1m4n00b6292/ME4169-Microprocessor-Final-term-Project/Department of Electrical Engineering/Docs/Reverse Protection.jpg

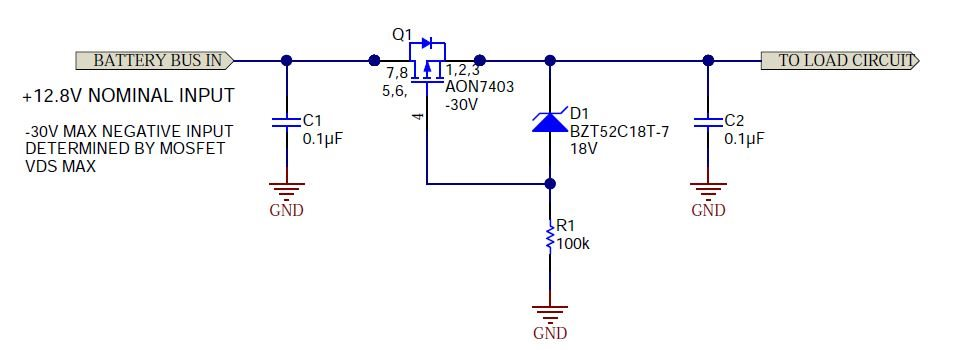
Department of Electrical Engineering/Docs/Reverse Protection.jpg
