1m4n00b6292/ME4169-Microprocessor-Final-term-Project/Department of Electrical Engineering/Util/tactile-switches-6mm-tht-r-a-1.snapshot.3/TS6-THT-RA.png

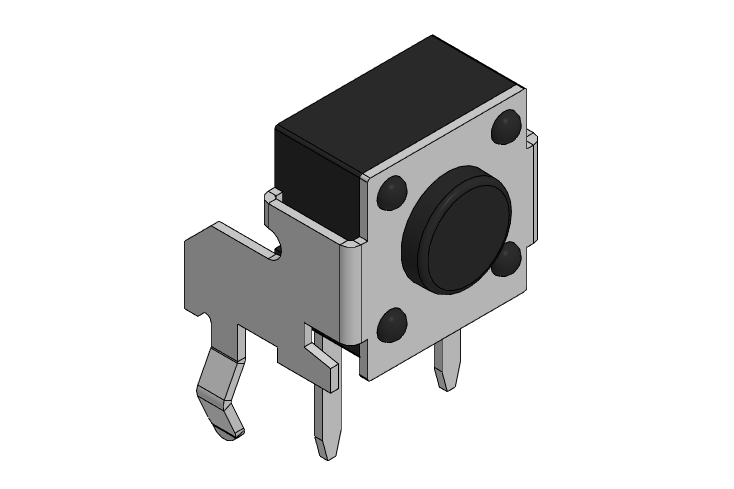
Department of Electrical Engineering/Util/tactile-switches-6mm-tht-r-a-1.snapshot.3/TS6-THT-RA.png
