1m4n00b6292/ME4169-Microprocessor-Final-term-Project/Picture/3D_Back.png

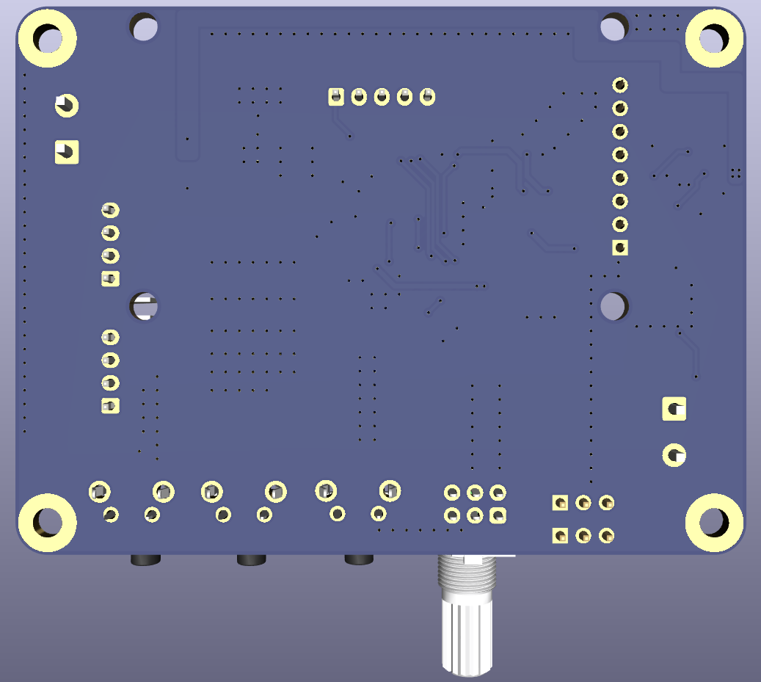
Picture/3D_Back.png
