1m4n00b6292/ME4169-Microprocessor-Final-term-Project/Picture/Layout_Back.png

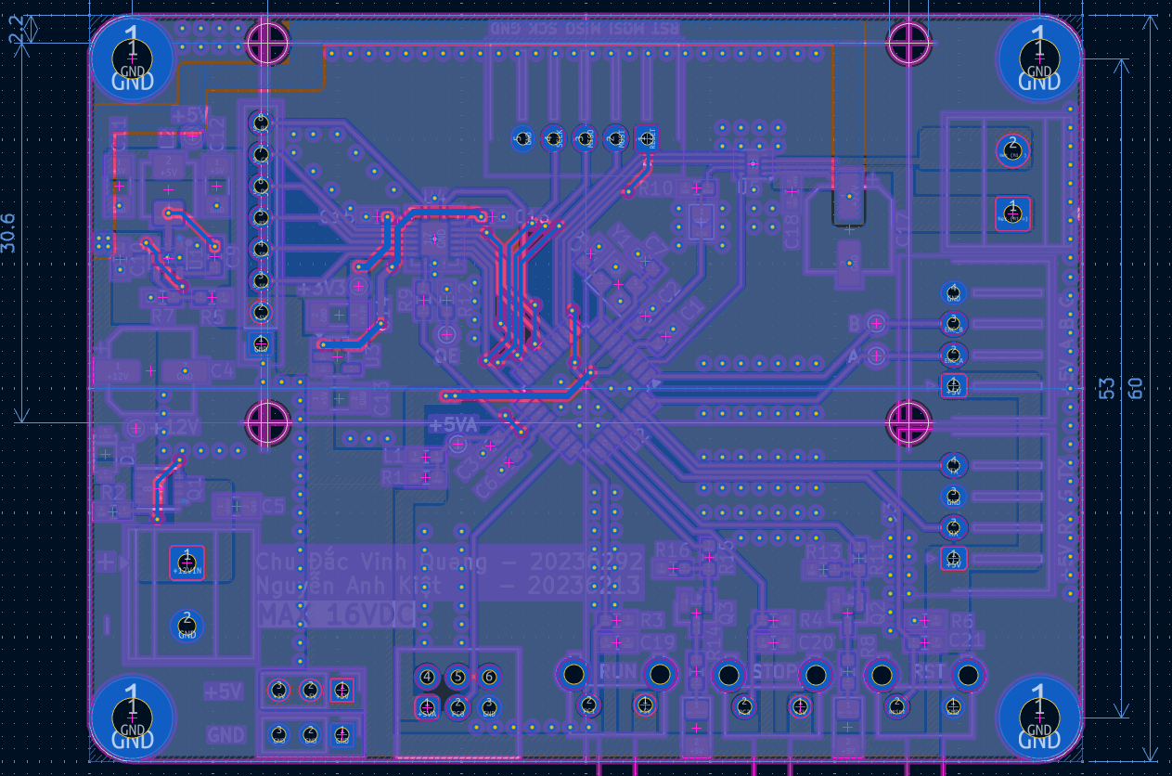
Picture/Layout_Back.png
