1m4n00b6292/ME4169-Microprocessor-Final-term-Project/Department of Electrical Engineering/中国制造的PCB/VI XU LY.xlsx

Qty | Value | Footprint
2 | BZT52C10 | SOD-123
2 | 10uH | 0603
2 | 10uH | 0420
2 | CSD25404Q3 | VSON-8 3.3x3.3mm
100 | 13.7K | 0603
2 | LMR51420XFDDCR | SOT-23-6
2 | AP2112K-3.3 | SOT23-5
2 | TXB0106RGY | Texas_RGY_R-PVQFN-N16_EP2.05x2.55mm
2 | DRV8220DSG | WSON-8
2 | 16MHz | 3225
