1m4n00b6292/ME4169-Microprocessor-Final-term-Project/Department of Electrical Engineering/Util/rv097ns-3.snapshot.1/RV097NS.step

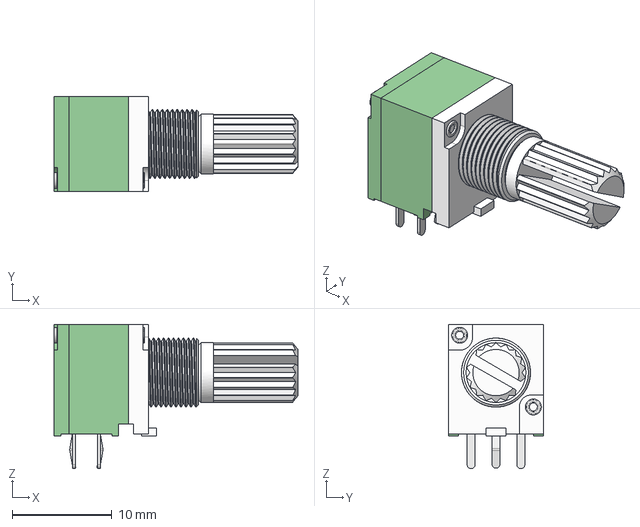
[picture p7: CAD file, 2026-11-09]
Department of Electrical Engineering/Util/rv097ns-3.snapshot.1/RV097NS.step
24.5 x 9.50 x 14.5 mm
