1m4n00b6292/ME4169-Microprocessor-Final-term-Project/Department of Mechanical Engineering/Cover.SLDPRT

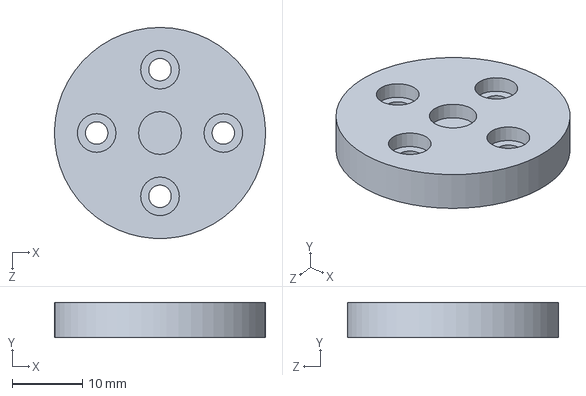
[picture p9: CAD file, 2026-11-09]
Department of Mechanical Engineering/Cover.SLDPRT
30.0 x 5.00 x 30.0 mm
