1m4n00b6292/ME4169-Microprocessor-Final-term-Project/Department of Mechanical Engineering/Fab/Flange.STEP

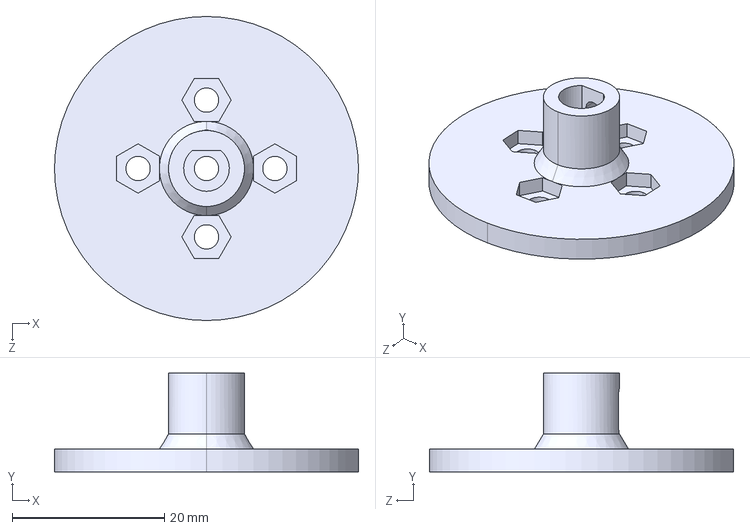
[picture p10: CAD file, 2026-11-09]
Department of Mechanical Engineering/Fab/Flange.STEP
40.0 x 13.0 x 40.0 mm
