1m4n00b6292/ME4169-Microprocessor-Final-term-Project/Department of Electrical Engineering/Util/tactile-switches-6mm-tht-r-a-1.snapshot.3/models3d/Switches/TS6-THT-RA_H-13.0.step

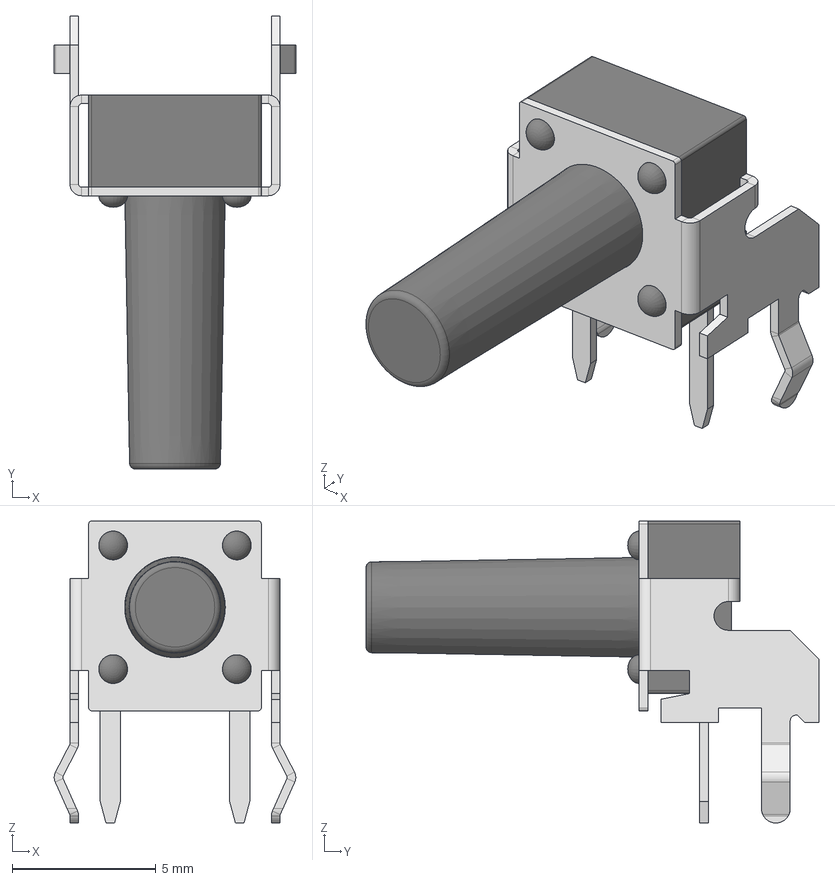
[picture p14: CAD file, 2026-11-09]
Department of Electrical Engineering/Util/tactile-switches-6mm-tht-r-a-1.snapshot.3/models3d/Switches/TS6-THT-RA_H-13.0.step
8.40 x 15.8 x 10.5 mm
