1m4n00b6292/ME4169-Microprocessor-Final-term-Project/(list of files, cad)

Other CAD files:
Department of Mechanical Engineering/Fab/Cover.STEP
Department of Mechanical Engineering/Flange.SLDPRT
Department of Electrical Engineering/Util/rv097ns-3.snapshot.1/RV097NS.stl
Department of Mechanical Engineering/Fab/Cover.3mf
