1m4n00b6292/ME4169-Microprocessor-Final-term-Project/Department of Electrical Engineering/中国制造的PCB/VI XU LY.pdf

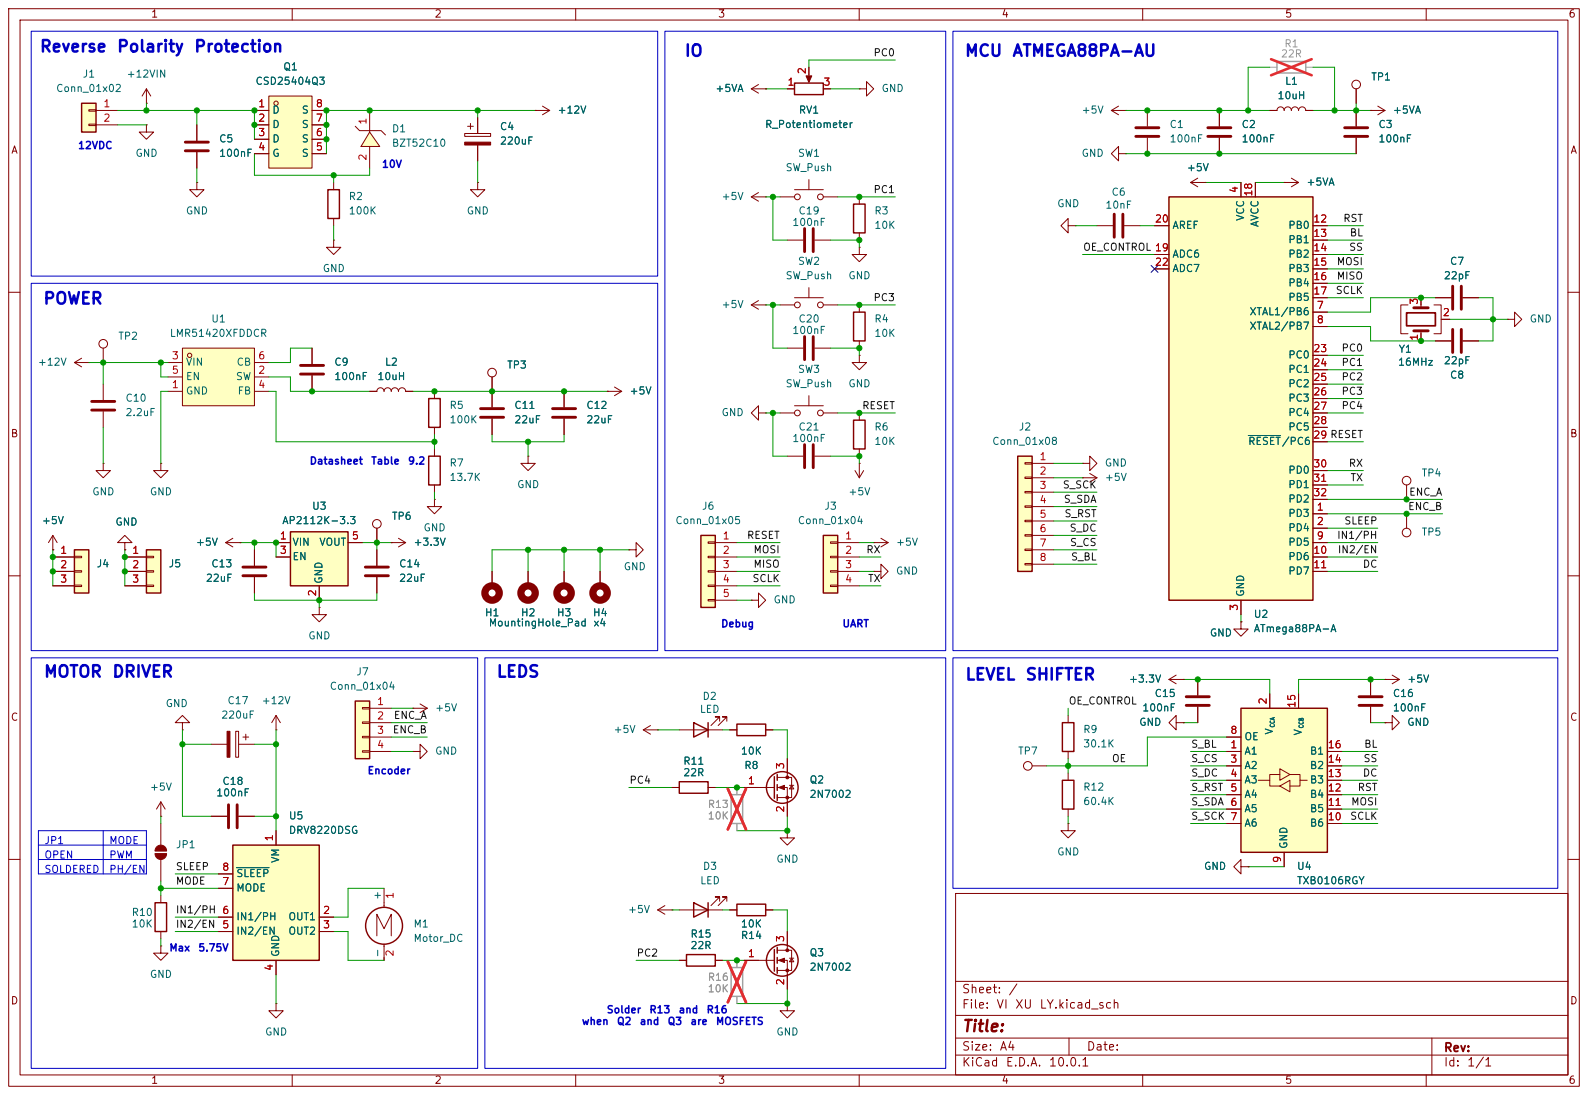
[picture p16: page 1]

Sheet: /
File: VI XU LY.kicad_sch
Title:

Size: A4 | Rev:
KiCad E.D.A. 10.0.1 | Id: 1/1
