1m4n00b6292/ME4169-Microprocessor-Final-term-Project/Department of Electrical Engineering/中国制造的PCB/VI XU LY.kicad_pcb

## KiCad design Department of Electrical Engineering/中国制造的PCB/VI XU LY.kicad_pcb (2026-11-09)

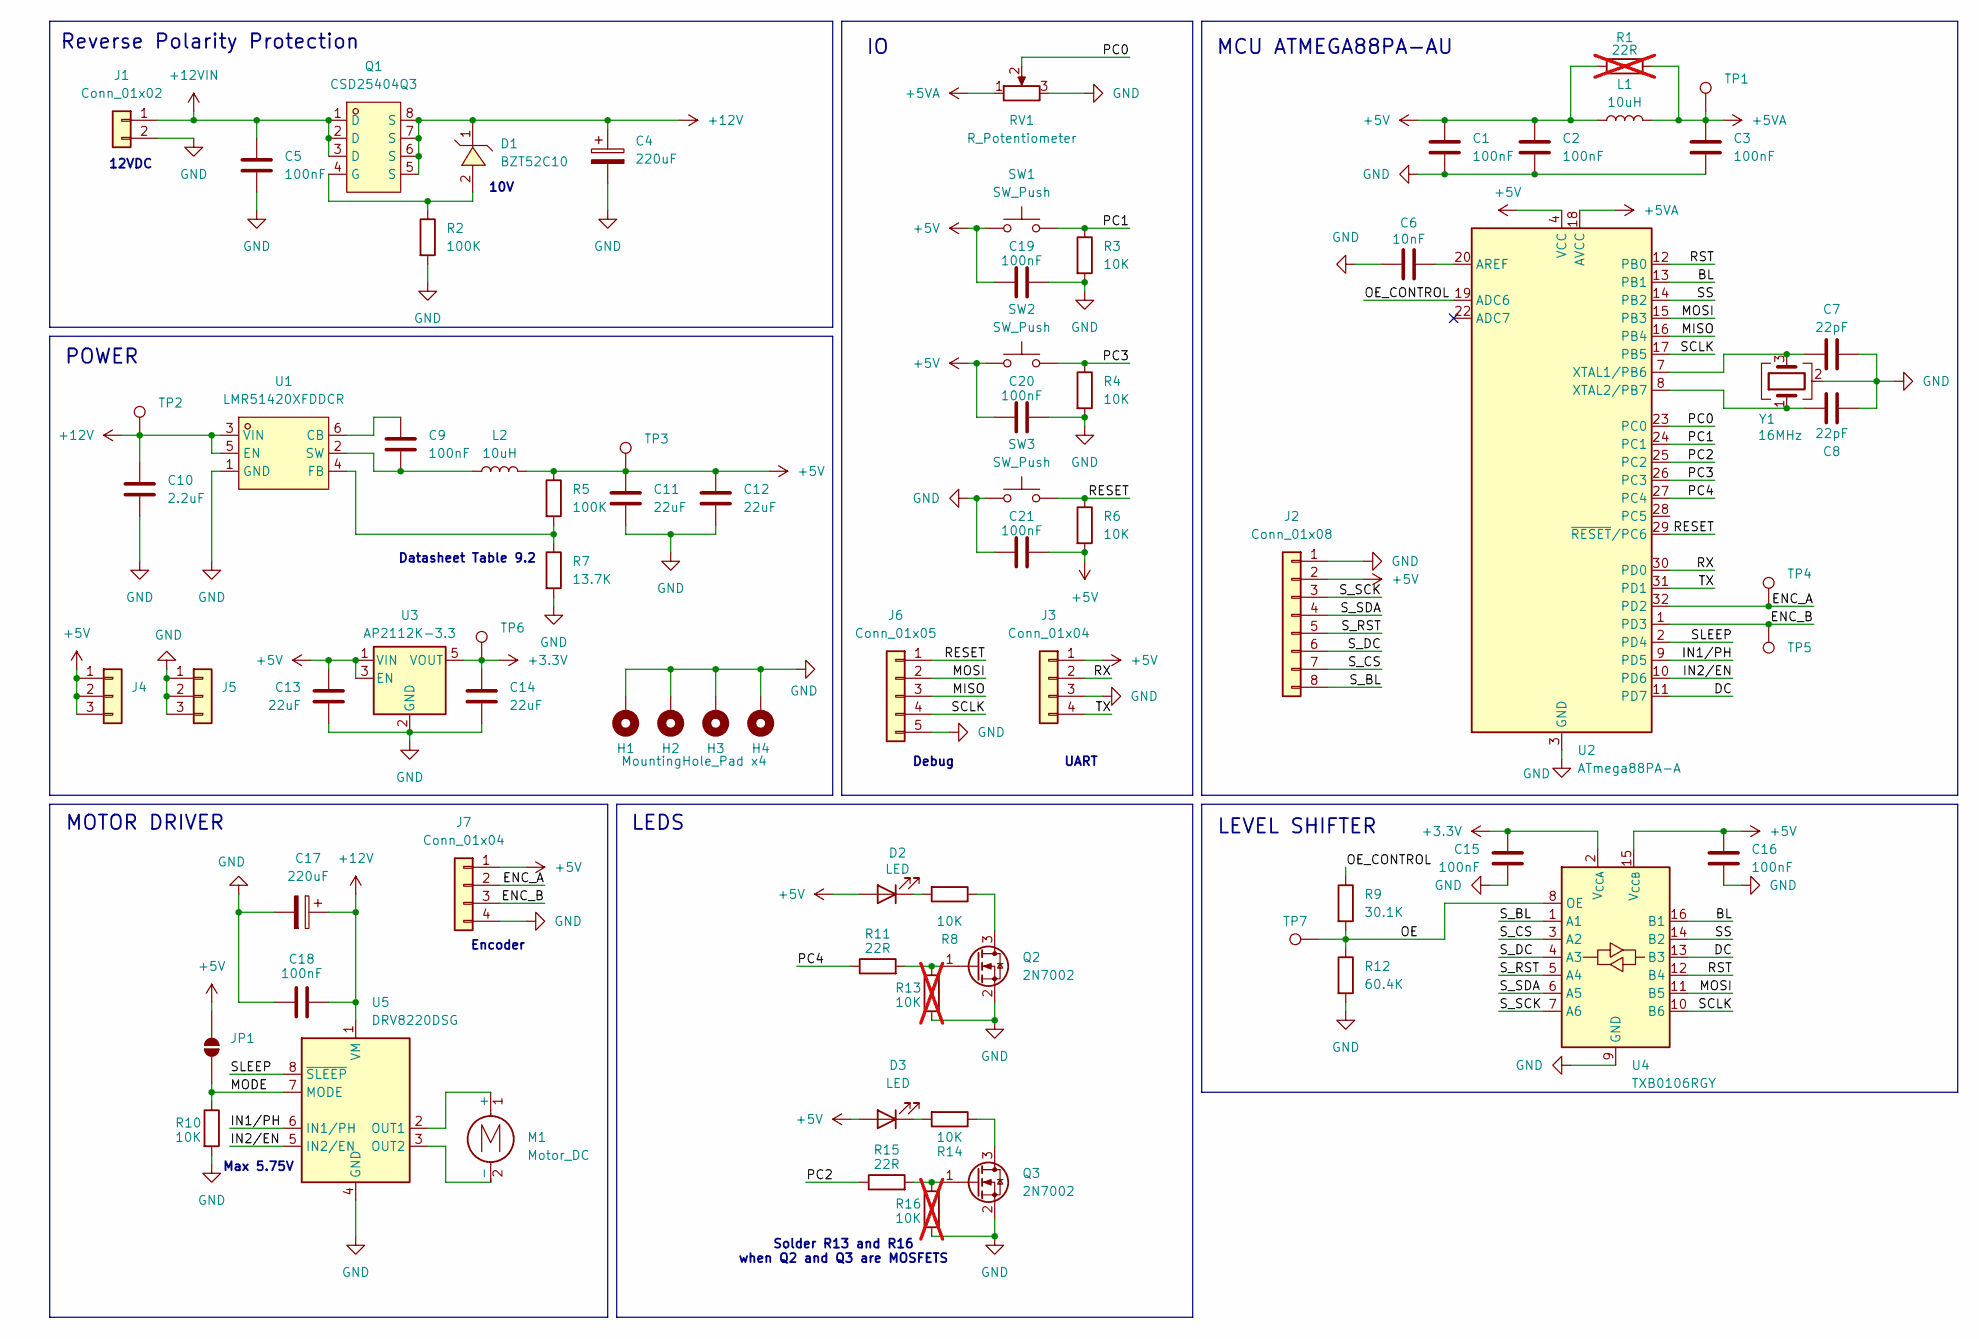
[picture p17: schematic VI XU LY.kicad_sch]

Parts:
C1, C2, C3, C9, C15, C16, C18, C19, C20, C21: 100nF; C_0603_1608Metric_Pad1.08x0.95mm_HandSolder
C4, C17: 220uF; CP_Elec_6.3x7.7
C5: 100nF; C_0805_2012Metric_Pad1.18x1.45mm_HandSolder
C6: 10nF; C_0603_1608Metric_Pad1.08x0.95mm_HandSolder
C7, C8: 22pF; C_0603_1608Metric_Pad1.08x0.95mm_HandSolder
C10: 2.2uF; C_0603_1608Metric_Pad1.08x0.95mm_HandSolder
C11, C12, C13, C14: 22uF; C_1206_3216Metric_Pad1.33x1.80mm_HandSolder
D1: BZT52C10; SOD-123_L2.8-W1.8-LS3.7-RD; MPN BZT52C10; LCSC Part C173431
D2, D3: LED; LED_1206_3216Metric_Pad1.42x1.75mm_HandSolder
H1, H2, H3: MountingHole_Pad; MountingHole_3.2mm_M3_Pad_TopBottom
H4: MountingHole_Pad x4; MountingHole_3.2mm_M3_Pad_TopBottom
J1: Conn_01x02; TerminalBlock_Phoenix_MKDS-1,5-2-5.08_1x02_P5.08mm_Horizont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
J2: Conn_01x08; PinSocket_1x08_P2.54mm_Vertical
J3, J7: Conn_01x04; JST_XH_S4B-XH-A-1_1x04_P2.50mm_Horizontal
J4, J5: Conn_01x03; PinHeader_1x03_P2.54mm_Vertical
J6: Conn_01x05; JST_XH_S5B-XH-A-1_1x05_P2.50mm_Horizontal
JP1: SolderJumper_2_Open; SolderJumper-2_P1.3mm_Open_TrianglePad1.0x1.5mm
L1: 10uH; L_0603_1608Metric_Pad1.05x0.95mm_HandSolder
L2: 10uH; L_Vishay_IHLP-1616
M1: Motor_DC; TerminalBlock_Phoenix_MKDS-1,5-2-5.08_1x02_P5.08mm_Horizont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
Q1: CSD25404Q3; VSON-CLIP-8_L3.3-W3.3-P0.65-BL; MPN CSD25404Q3; LCSC Part C2865523
Q2, Q3: 2N7002; SOT-23
R1: 22R; R_0603_1608Metric_Pad0.98x0.95mm_HandSolder; not fitted
R2, R5: 100K; R_0603_1608Metric_Pad0.98x0.95mm_HandSolder
R3, R4, R6, R8, R10, R14: 10K; R_0603_1608Metric_Pad0.98x0.95mm_HandSolder
R7: 13.7K; R_0603_1608Metric_Pad0.98x0.95mm_HandSolder
R9: 30.1K; R_0603_1608Metric_Pad0.98x0.95mm_HandSolder
R11, R15: 22R; R_0603_1608Metric_Pad0.98x0.95mm_HandSolder
R12: 60.4K; R_0603_1608Metric_Pad0.98x0.95mm_HandSolder
R13, R16: 10K; R_0603_1608Metric_Pad0.98x0.95mm_HandSolder; not fitted
RV1: R_Potentiometer; Potentiometer_Alps_RK097_Dual_Horizontal
SW1, SW2, SW3: SW_Push; SW_SPST_Omron_B3F-315x_Angled
TP1, TP2, TP3, TP4, TP5, TP6, TP7: TestPoint; TestPoint_Pad_D1.0mm
U1: LMR51420XFDDCR; SOT-23-6_L2.9-W1.6-P0.95-LS2.8-BL; MPN LMR51420XFDDCR; LCSC Part C5752071
U2: ATmega88PA-A; TQFP-32_7x7mm_P0.8mm
U3: AP2112K-3.3; SOT-23-5
U4: TXB0106RGY; Texas_RGY_R-PVQFN-N16_EP2.05x2.55mm
U5: DRV8220DSG; WSON-8-1EP_2x2mm_P0.5mm_EP0.9x1.6mm
Y1: 16MHz; Crystal_SMD_3225-4Pin_3.2x2.5mm

Connections:
+3.3V: C14.1, C15.1, TP6.1 (1_1), U3.5 (VOUT), U4.2 (V_{CCA})
+5V: C1.1, C2.1, C11.1, C12.1, C13.1, C16.1, C19.1, C20.1, C21.2, D2.2 (A), D3.2 (A), J2.2, J3.1, J4.1, J4.2, J4.3, J7.1, JP1.2 (B), L1.1, L2.2, R1.1, R5.1, R6.2, SW1.1, SW2.1, TP3.1 (1_1), U2.4 (VCC), U2.6 (VCC), U3.1 (VIN), U3.3 (EN), U4.15 (V_{CCB})
+5VA: C3.1, L1.2, R1.2, RV1.1, TP1.1 (1_1), U2.18 (AVCC)
+12V: C4.1, C10.1, C17.1, C18.2, D1.1, Q1.5 (S), Q1.6 (S), Q1.7 (S), Q1.8 (S), TP2.1 (1_1), U1.3 (VIN), U1.5 (EN), U5.1 (VM)
+12VIN: C5.1, J1.1, Q1.1 (D), Q1.2 (D), Q1.3 (D)
/BL: U2.13 (PB1), U4.16 (B1)
/DC: U2.11 (PD7), U4.13 (B3)
/ENC_A: J7.2, TP4.1 (1_1), U2.32 (PD2)
/ENC_B: J7.3, TP5.1 (1_1), U2.1 (PD3)
/IN1/PH: U2.9 (PD5), U5.6 (IN1/PH)
/IN2/EN: U2.10 (PD6), U5.5 (IN2/EN)
/MISO: J6.3, U2.16 (PB4)
/MODE: JP1.1 (A), R10.1, U5.7 (MODE)
/MOSI: J6.2, U2.15 (PB3), U4.11 (B5)
/OE: R9.2, R12.1, TP7.1 (1_1), U4.8 (OE)
/OE_CONTROL: R9.1, U2.19 (ADC6)
/PC0: RV1.2, U2.23 (PC0)
/PC1: R3.1, SW1.2, U2.24 (PC1)
/PC2: R15.1, U2.25 (PC2)
/PC3: R4.1, SW2.2, U2.26 (PC3)
/PC4: R11.1, U2.27 (PC4)
/RESET: J6.1, R6.1, SW3.2, U2.29 (~RESET/PC6)
/RST: U2.12 (PB0), U4.12 (B4)
/RX: J3.2, U2.30 (PD0)
/SCLK: J6.4, U2.17 (PB5), U4.10 (B6)
/SLEEP: U2.2 (PD4), U5.8 (~SLEEP)
/SS: U2.14 (PB2), U4.14 (B2)
/S_BL: J2.8, U4.1 (A1)
/S_CS: J2.7, U4.3 (A2)
/S_DC: J2.6, U4.4 (A3)
/S_RST: J2.5, U4.5 (A4)
/S_SCK: J2.3, U4.7 (A6)
/S_SDA: J2.4, U4.6 (A5)
/TX: J3.4, U2.31 (PD1)
GND: C1.2, C2.2, C3.2, C4.2, C5.2, C6.2, C7.2, C8.2, C10.2, C11.2, C12.2, C13.2, C14.2, C15.2, C16.2, C17.2, C18.1, C19.2, C20.2, C21.1, H1.1 (1_1), H2.1 (1_1), H3.1 (1_1), H4.1 (1_1), J1.2, J2.1, J3.3, J5.1, J5.2, J5.3, J6.5, J7.4, Q2.2 (S), Q3.2 (S), R2.2, R3.2, R4.2, R7.2, R10.2, R12.2, R13.2, R16.2, RV1.3, SW3.1, U1.1 (GND), U2.3 (GND), U2.5 (GND), U2.21 (GND), U3.2 (GND), U4.9 (GND), U4.17 (GND), U5.4 (GND), U5.9 (GND), Y1.2 (G), Y1.4 (G)
unnamed: D2.1 (K), R8.2
unnamed: D3.1 (K), R14.2
unnamed: M1.1 (+), U5.2 (OUT1)
unnamed: M1.2 (-), U5.3 (OUT2)
unnamed: D1.2, Q1.4 (G), R2.1
unnamed: Q2.3 (D), R8.1
unnamed: Q2.1 (G), R11.2, R13.1
unnamed: Q3.3 (D), R14.1
unnamed: Q3.1 (G), R15.2, R16.1
unnamed: C9.1, U1.6 (CB)
unnamed: R5.2, R7.1, U1.4 (FB)
unnamed: C9.2, L2.1, U1.2 (SW)
unnamed: C6.1, U2.20 (AREF)
unnamed: C7.1, U2.7 (XTAL1/PB6), Y1.3
unnamed: C8.1, U2.8 (XTAL2/PB7), Y1.1

Notes on the sheet:
Datasheet Table 9.2
UART
12VDC
POWER
LEVEL SHIFTER
Reverse Polarity Protection
LEDS
10V
Solder R13 and R16 when Q2 and Q3 are MOSFETS
MOTOR DRIVER
Debug
MCU ATMEGA88PA-AU
Encoder
Max 5.75V

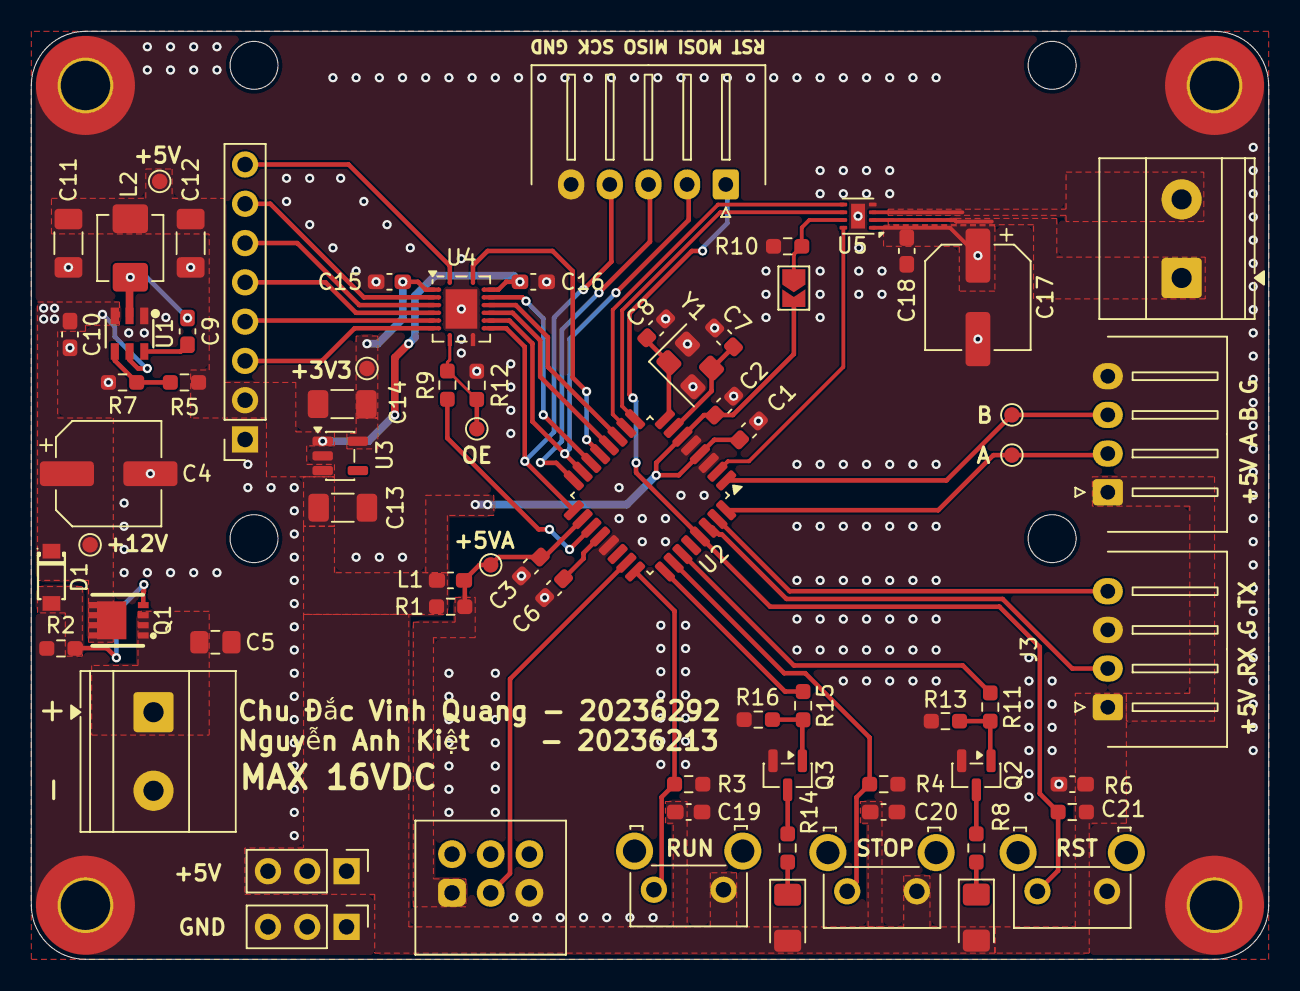
[picture p18: board VI XU LY.kicad_pcb from above]

Board: 2 copper layers, 80.0 x 60.0 mm, 75 parts (0 on the bottom side), 50 nets.
